ProtonKicker/neptune3pro/Hardware/PCBA/Filament detector/Filament detector bom.xls

Items | Part name | Packag description | Qty | Bit number
1 | SMD Capacitor | 4.7UF/0603/25V/K/X5R，brand restrict ：not | 1 | C1
2 | SMD indicator light led | 0603/blue，brand restrict ：(Everlight Electronics., Ltd.) | 1 | D1
3 | connector | XH2.54-3PW，90 degree connector，Fireproof material | 1 | J1
4 | Transistor | SMD Transistor_SOT-23_SL3400 | 1 | Q1
5 | SMD resistor | 0603_1KR_accuracy 1% | 1 | R5
6 | SMD resistor | 0603_470R_accuracy 1% | 1 | R3
7 | SMD resistor | 0603_2.2KR_accuracy 1% | 1 | R4
8 | SMD resistor | 0603_10KR_accuracy 1% | 2 | R1 R2
9 | optocoupler | BH-ITR20403S brand restrict ：not | 1 | U1
10 | pcb | 18.2×12.6mm，FR-4，two-layer board，FR4_1.6mm，red Soldermask and white silkscreen ， HAL lead free technology ，Through hole and oil，Thickness of copper sheet:1oz，version：EL-A-V3.3.3.102 | 1
