ProtonKicker/neptune3pro/Hardware/PCBA/LED/NEP3_PRO_LED bom.xls

Items | Part name | Packag description | Qty | Bit number
1 | connector | XH2.54MM-2P，SMD Recumbent Soldering，Fireproof material | 1 | 24VIN
2 | SMD resistor | 1206_220R_accuracy 1% | 4 | R1 R2 R3 R4
3 | LED | SMD Recumbent Soldering 3528，white light，20mA，restrict ：not | 24 | U1 U2 U3 U4 U5 U6 U7 U8 U9 U10 U11 U12 U13 U14 U15 U16 U17 U18 U19 U20 U21 U22 U23 U24
4 | PCB | 178*15.2mm，Aluminum substrate，Single layer board，Plate thickness_1.5mm，red Soldermask and white silkscreen ， HAL lead free technology ，Through hole and oil，Thickness of copper sheet:1oz， EL-A-V1.7.72.100 | 1
