ProtonKicker/neptune3pro/Hardware/PCBA/Limit Switch/Y-axis limit switch BOM.xlsx

Limit Switch BOM
Items | Part Name | Specification | UNIT | Qty
1 | PCB | Red | pcs | 1
2 | Switch | Fragment microswitch | pcs | 1
3 | Connector | 2.54-3Pin | pcs | 1
4 | Screws | Cruciform Socket Button Head Tapping screws_Point Tail/PA 2x8 | pcs | 2
