ProtonKicker/neptune3pro/Hardware/3D/Misc Imports/3010 Axial Fan.step

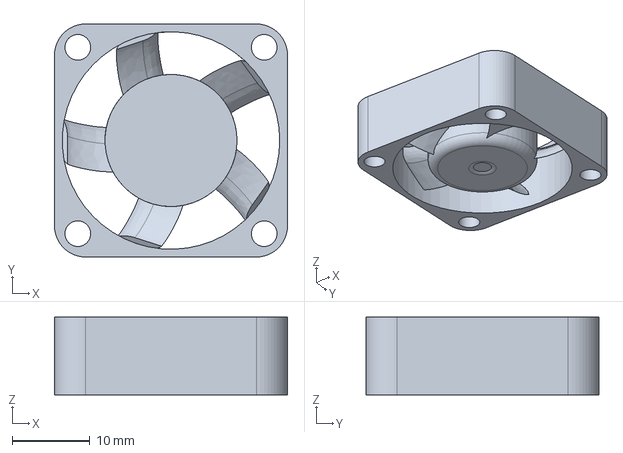
[picture p1: CAD file, 2026-10-06]
Hardware/3D/Misc Imports/3010 Axial Fan.step
30.0 x 30.0 x 10.0 mm
