ProtonKicker/neptune3pro/(list of files, cad)

Other CAD files:
Hardware/Wire/Mainboard Wire.dwg
Hardware/3D/SolidWorks/Power Supply_Kit.SLDASM
Hardware/3D/SolidWorks/Nozzle_Module.SLDASM
Hardware/3D/SolidWorks/Z-axis Driven Plate_Kit.SLDASM
Hardware/3D/SolidWorks/V-slot Wheel kit-1.SLDASM
Hardware/3D/SolidWorks/Extruder_Kit.SLDASM
Hardware/3D/SolidWorks/X-Stepper_Module.SLDASM
Hardware/3D/SolidWorks/Y-Stepper_Kit.SLDASM
Hardware/3D/SolidWorks/V-slot Wheel kit-9.SLDASM
Hardware/3D/SolidWorks/V-slot Wheel kit-8.SLDASM
Hardware/3D/SolidWorks/V-slot Wheel kit-6.SLDASM
Hardware/3D/SolidWorks/Z-Stepper_Kit-Right.SLDASM
Hardware/3D/SolidWorks/V-slot Wheel kit-13.SLDASM
Hardware/3D/SolidWorks/Heated Bed Platform_Module.SLDASM
Hardware/3D/SolidWorks/Filament Detector_Module.SLDASM
Hardware/3D/SolidWorks/Y-axis Timing Belt_Kit.SLDASM
Hardware/3D/SolidWorks/Bottom Aluminum profile_Kit.SLDASM
Hardware/3D/SolidWorks/Bottom Slider Plate_Kit.SLDASM
Hardware/3D/SolidWorks/Extrusion Gear 2 Kit.SLDASM
Hardware/3D/SolidWorks/X-axis Limit switch _Kit.SLDASM
Hardware/3D/SolidWorks/Belt Adjust Bearing Holder_Kit-1.SLDASM
Hardware/3D/SolidWorks/Bottom_Kit.SLDASM
Hardware/3D/SolidWorks/X-axis Timing Belt_Kit.SLDASM
Hardware/3D/SolidWorks/Display screen_Kit.SLDASM
Hardware/3D/SolidWorks/X-axis_Kit.SLDASM
Hardware/3D/SolidWorks/Top Beam_Kit.SLDASM
Hardware/3D/SolidWorks/V-slot Wheel kit-11.SLDASM
Hardware/3D/SolidWorks/V-slot Wheel kit-5.SLDASM
Hardware/3D/SolidWorks/Belt Adjust Bearing Holder_Kit.SLDASM
Hardware/3D/SolidWorks/Bottom Cover Plate_Kit.SLDASM
Hardware/3D/SolidWorks/V-slot Wheel kit-10.SLDASM
Hardware/3D/SolidWorks/Combination Switch_Kit.SLDASM
Hardware/3D/SolidWorks/PEI Platform Sticker_Kit.SLDASM
Hardware/3D/SolidWorks/Y-axis belt Adjust _Kit.SLDASM
Hardware/3D/SolidWorks/Z-Stepper_Kit-Left.SLDASM
Hardware/3D/SolidWorks/Mainboard.SLDPRT
Hardware/3D/SolidWorks/X-axis belt Adjust _Kit.SLDASM
Hardware/3D/SolidWorks/Filament holder_Kit.SLDASM
Hardware/3D/SolidWorks/V-slot Wheel kit-12.SLDASM
Hardware/3D/SolidWorks/V-slot Wheel kit-4.SLDASM
Hardware/3D/SolidWorks/Extruder Shell_Kit.SLDASM
Hardware/3D/SolidWorks/Extruder PCBA.SLDASM
Hardware/3D/SolidWorks/Gearbox_Module(Ä¬ÈÏ-_flexible1).SLDASM
Hardware/3D/SolidWorks/Heated Bed Platform_Kit.SLDASM
Hardware/3D/SolidWorks/Fixing Plate_Extruder_Kit.SLDASM
Hardware/3D/SolidWorks/Bottom Slider Plate_Module.SLDASM
Hardware/3D/SolidWorks/V-slot Wheel kit-7.SLDASM
Hardware/3D/SolidWorks/Bottom Box_Kit.SLDASM
Hardware/3D/SolidWorks/V-slot Wheel kit.SLDASM
Hardware/3D/SolidWorks/V-slot Wheel kit-3.SLDASM
Hardware/3D/SolidWorks/Z-axis Aluminum profile_Kit.SLDASM
Hardware/3D/SolidWorks/V-slot Wheel kit-2.SLDASM
Hardware/2D/2040 Aluminum profile_Right.DWG
Hardware/3D/SolidWorks/624zz V Bearing.SLDPRT
Hardware/Wire/Stepper and limit switch wire_X-axis.dwg
Hardware/2D/Power Supply Cover-Bottom.DWG
Hardware/Wire/Fan Wire.dwg
Hardware/2D/4040 Aluminum profile_Bottom & Right.DWG
Hardware/Wire/Heated Bed Wire.dwg
Hardware/3D/SolidWorks/Level Sensor.SLDPRT
Hardware/Wire/Thermistor_Nozzle.dwg
Hardware/2D/Attraction Plate_Magnet.DWG
Hardware/3D/SolidWorks/4015 Turbo Fan.SLDPRT
Hardware/Wire/Filament Detector and LED Wire.dwg
Hardware/2D/4040 Aluminum profile_Bottom & Left.DWG
Hardware/3D/SolidWorks/Timing Pulley_ID 8.SLDPRT
Hardware/2D/Fixing Plate_Extruder.DWG
Hardware/Wire/stepper and limit switch wire_Y-axis.dwg
Hardware/2D/Cover Plate_Bottom.DWG
Hardware/Wire/Extruder Cable.dwg
Hardware/2D/Extrusion Gear 2.DWG
Hardware/3D/SolidWorks/2GT Timing Belt_Close.SLDPRT
Hardware/Wire/Ground Wire_Power Supply.dwg
Hardware/2D/2040 Aluminum profile_Left.DWG
Hardware/Wire/Filament Detector Wire.dwg
Hardware/2D/2020 Aluminum profile_X-axis.DWG
Hardware/3D/SolidWorks/Axis_Extrusion Gear holder_L27.SLDPRT
Hardware/Wire/Level Sensor.dwg
Hardware/2D/2056 Aluminum profile_Y-axis.DWG
Hardware/3D/SolidWorks/Cable Tie holder.SLDPRT
Hardware/Wire/4010 Turbo Fan.dwg
Hardware/2D/Fixing Plate_Magnet.DWG
Hardware/3D/SolidWorks/Fan holder_Extruder.SLDPRT
Hardware/Wire/Red Silicone Wire(Switch).dwg
Hardware/2D/Fixing Plate_Extruder Fan.DWG
Hardware/3D/SolidWorks/Stepper_X-axis&Y-axis.SLDPRT
Hardware/Wire/4015 Turbo Fan.dwg
Hardware/2D/Power Supply Cover_Left.DWG
Hardware/3D/SolidWorks/Attraction Plate_Magnet.SLDPRT
Hardware/Wire/Red Silicone Wire.dwg
Hardware/2D/Fixing Plate_Y-axis stepper.DWG
Hardware/Wire/Heating Tube.dwg
Hardware/2D/Driven Plate_Z-axis.DWG
Hardware/Wire/6010 Fan.dwg
Hardware/2D/Heat Dissipation Block.DWG
Hardware/3D/SolidWorks/Cover_4040 Aluminum profile.SLDPRT
Hardware/Wire/Black DC Wire.dwg
Hardware/2D/4040 Aluminum profile_Bottom.DWG
Hardware/Wire/Display Screen Wire_Inside.dwg
Hardware/2D/Extrusion Gear 1.DWG
Hardware/3D/SolidWorks/Heated Bed Spacer.SLDPRT
Hardware/Wire/Stepper wire_Z-axis.dwg
Hardware/2D/Fixing Plate_X-axis-stepper.DWG
Hardware/Wire/Red DC Wire.dwg
Hardware/2D/Fixing Plate_Extruder Cable.DWG
Hardware/3D/SolidWorks/Nozzle.SLDPRT
Hardware/Wire/Black Silicone Wire.dwg
Hardware/3D/SolidWorks/Fixing Plate_Magnet(Ä¬ÈÏ).SLDPRT
Hardware/Wire/Thermistor_Heated Bed.dwg
Hardware/2D/Bottom Slider Plate.DWG
Hardware/Wire/LED Wire.dwg
Hardware/2D/Heated Blcok.DWG
Hardware/2D/Power Supply Cover_Right.DWG
Hardware/2D/Fixing Plate_Filament Detector Switch.DWG
Hardware/3D/SolidWorks/PET Plastic Sheet.SLDPRT
Hardware/2D/Fixing Plate_Top Bearing.DWG
Hardware/3D/SolidWorks/Fixing Plate_X-axis-stepper(Ä¬ÈÏ).SLDPRT
Hardware/3D/SolidWorks/Plastic Bottom Cover_Front.SLDPRT
Hardware/3D/SolidWorks/Belt Adjust Bearing Holder.SLDPRT
Hardware/3D/SolidWorks/Filament Detector Shell_Top.SLDPRT
Hardware/3D/SolidWorks/F624ZZ Bearing.SLDPRT
Hardware/3D/SolidWorks/Belt Adjust Shell_Y-axis.SLDPRT
Hardware/3D/SolidWorks/Needle Bearing.SLDPRT
Hardware/3D/SolidWorks/Filament Tube.SLDPRT
Hardware/3D/SolidWorks/Bearing holder_Filament Detector.SLDPRT
Hardware/3D/SolidWorks/Fixing Plate_Top Bearing(Ä¬ÈÏ).SLDPRT
Hardware/3D/SolidWorks/Cover Plate_Bottom(Ä¬ÈÏ).SLDPRT
Hardware/3D/SolidWorks/RJ11 Wire.SLDPRT
Hardware/3D/SolidWorks/2040 Aluminum profile_Left.SLDPRT
Hardware/3D/SolidWorks/Extruder Handle.SLDPRT
Hardware/3D/SolidWorks/Wire Protective Ring.SLDPRT
Hardware/3D/SolidWorks/Silicone Cover_Heating Block.SLDPRT
Hardware/3D/SolidWorks/Fixing Plate_Extruder(Ä¬ÈÏ).SLDPRT
Hardware/3D/SolidWorks/Spring_Extrusion.SLDPRT
Hardware/3D/SolidWorks/Display Screen.SLDPRT
Hardware/3D/SolidWorks/Cable Snap.SLDPRT
Hardware/3D/SolidWorks/X-axis Timing Belt.SLDPRT
Hardware/3D/SolidWorks/Axis_Extrusion Gear_L19.SLDPRT
Hardware/3D/SolidWorks/625zz Bearing.SLDPRT
Hardware/3D/SolidWorks/limit switch holder_Y-axis.SLDPRT
Hardware/3D/SolidWorks/Power Supply Cover-Bottom(Ä¬ÈÏ).SLDPRT
Hardware/3D/SolidWorks/Display screen Shell_Bottom.SLDPRT
Hardware/3D/SolidWorks/Power Supply Cover_Left(Ä¬ÈÏ).SLDPRT
Hardware/3D/SolidWorks/Extruder Stepper Gear.SLDPRT
Hardware/3D/SolidWorks/Belt Adjust Shell_X-axis.SLDPRT
Hardware/3D/SolidWorks/MR93ZZ Bearing.SLDPRT
Hardware/3D/SolidWorks/Copper Sleeve_Timing Belt.SLDPRT
Hardware/3D/SolidWorks/Metal Spacer.SLDPRT
Hardware/3D/SolidWorks/Heat Dissipation Block.SLDPRT
Hardware/2D/Fixing Plate_Z nut-Left.DWG
Hardware/2D/Fixing Plate_Z nut-Right.DWG
Hardware/3D/Inventor/1.75mm Filament_Extruder.ipt
Hardware/3D/Inventor/1.75mm Filament_Filament Detector.ipt
Hardware/3D/Inventor/2.0-20Pin.ipt
Hardware/3D/Inventor/2020 Aluminum profile_X-axis.ipt
Hardware/3D/Inventor/2040 Aluminum profile_Left.ipt
Hardware/3D/Inventor/2040 Aluminum profile_Right.ipt
Hardware/3D/Inventor/2056 Aluminum profile_Y-axis.ipt
Hardware/3D/Inventor/2GT Timing Belt_Close.ipt
Hardware/3D/Inventor/4010 Turbo Fan.ipt
Hardware/3D/Inventor/4015 Turbo Fan.ipt
Hardware/3D/Inventor/4040 Aluminum profile_Bottom & Left.ipt
Hardware/3D/Inventor/4040 Aluminum profile_Bottom & Right.ipt
Hardware/3D/Inventor/4040 Aluminum profile_Bottom.ipt
Hardware/3D/Inventor/6010 Fan.ipt
Hardware/3D/Inventor/624zz V Bearing.ipt
Hardware/3D/Inventor/625zz Bearing.ipt
Hardware/3D/Inventor/625zz Bearing_1.ipt
Hardware/3D/Inventor/625zz Bearing_10.ipt
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
