ProtonKicker/neptune3pro/Hardware/2D/2020 Aluminum profile_X-axis.pdf

4

1 | 2 | 3

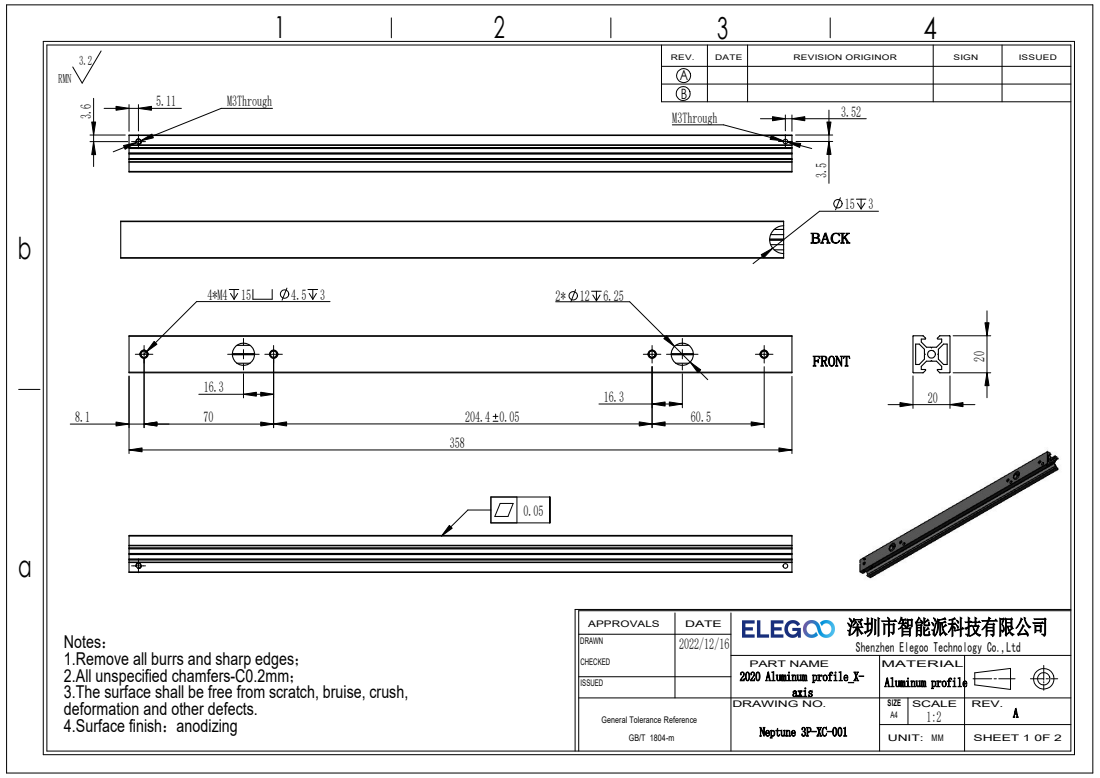
[picture p2: page 1]
Aluminum profile; RMN; M3Through; FRONT; BACK

REV. | DATE | REVISION ORIGINOR | SIGN | ISSUED

APPROVALS | DATE | 深圳市智能派科技有限公司 Shenzhen Elegoo Technology Co.,Ltd
DRAWN CHECKED | 2022/12/16
PART NAME 2020 Aluminum profile_X-axis | MATERIAL
ISSUED
General Tolerance Reference GB/T 1804-m | DRAWING NO. Neptune 3P-XC-001 | SIZE A4 | SCALE 1:2 | REV. A

Notes：
1.Remove all burrs and sharp edges；
2.All unspecified chamfers-C0.2mm；
3.The surface shall be free from scratch, bruise, crush,
deformation and other defects.
4.Surface finish：anodizing

UNIT: MM | | SHEET 1 0F 2
