ProtonKicker/neptune3pro/Hardware/2D/Extrusion Gear 1.pdf

M=0.5

Z=17

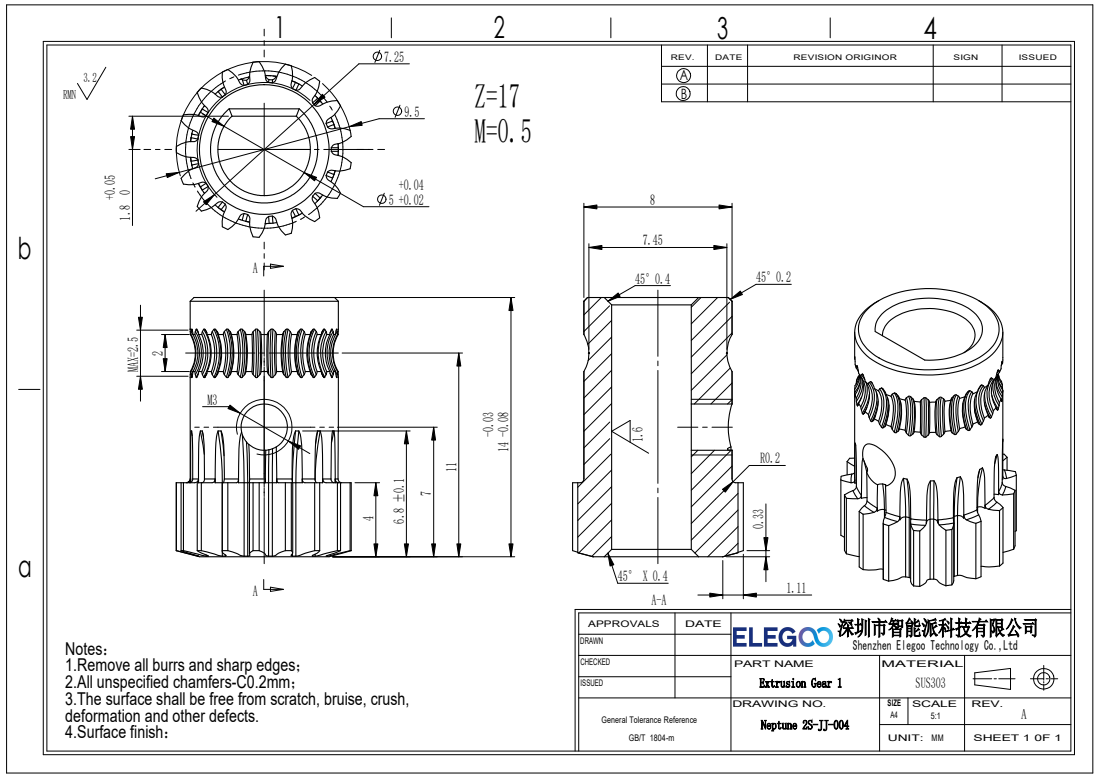
[picture p8: page 1]
MAX=2.5; RMN

REV. | DATE | REVISION ORIGINOR | SIGN | ISSUED

APPROVALS | DATE | 深圳市智能派科技有限公司 Shenzhen Elegoo Technology Co.,Ltd
DRAWN
CHECKED | | PART NAME Extrusion Gear 1 | MATERIAL SUS303
ISSUED
General Tolerance Reference GB/T 1804-m | DRAWING NO. Neptune 2S-JJ-004 | SIZE A4 | SCALE 5:1 | REV. A

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

UNIT: MM | | SHEET 1 0F 1
