ProtonKicker/neptune3pro/Hardware/PCBA/Filament detector/Filament detector_pcb.pdf

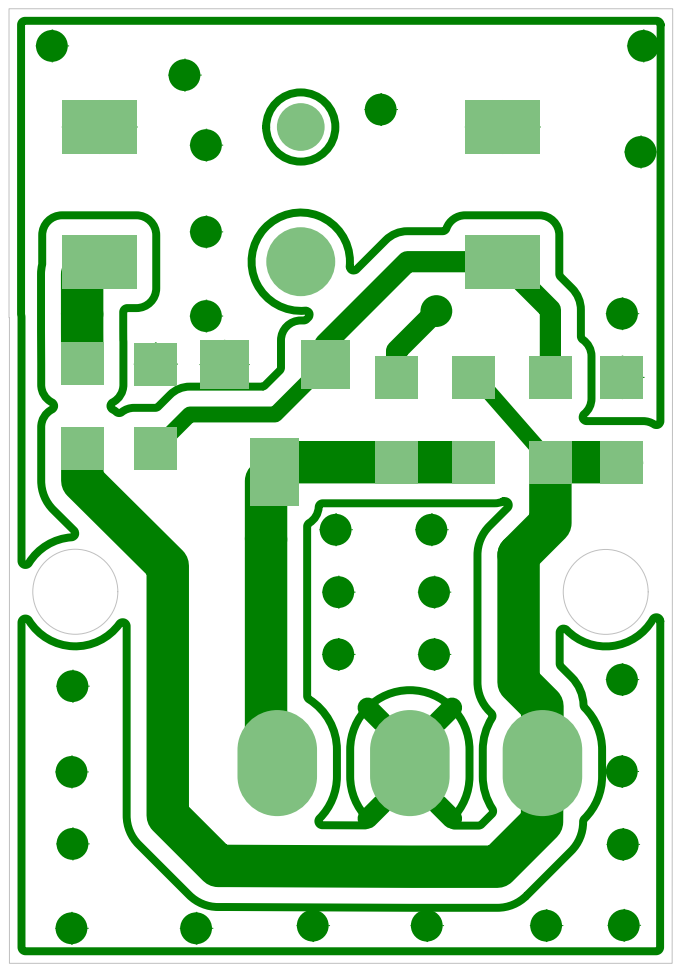
[picture p10: page 1]
U1U¹x1 U¹x2; R1R¹x1 R¹x2; R2R²x1 R²x2; R3R³x1 R³x2; R4R⁴x1 R⁴x2; C1C¹x1; R5R⁵x1 R⁵x2

¼¼ÊõÒªÇó£º
1.È¥Ã«´Ì£¬Àû½Çµ¹¶Û£»
2.Î´×¢µ¹½ÇC0.2£»
3.´ø*ºÅµÄ³ß´çÎªÖØµã³ß´ç£»
4.Î´×¢³ß´ç²ÎÕÕ3DÍ¼£»
5.±íÃæ·ÀÖ¹¹Î»¨¡¢ÅöÉË¡¢Ñ¹ÉË¡¢±äÐÎµÈ²»Á¼¡£
6.±íÃæ´¦Àí£ºÎÞ

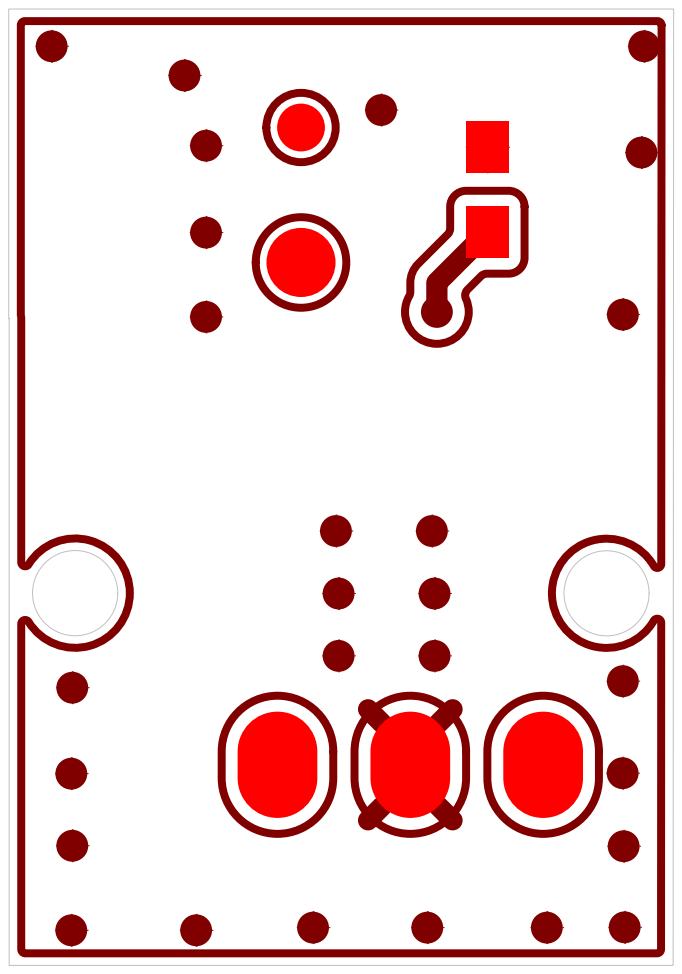
[picture p11: page 2]
U1U¹x5 U¹x6; D1D¹x1 D¹x2

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

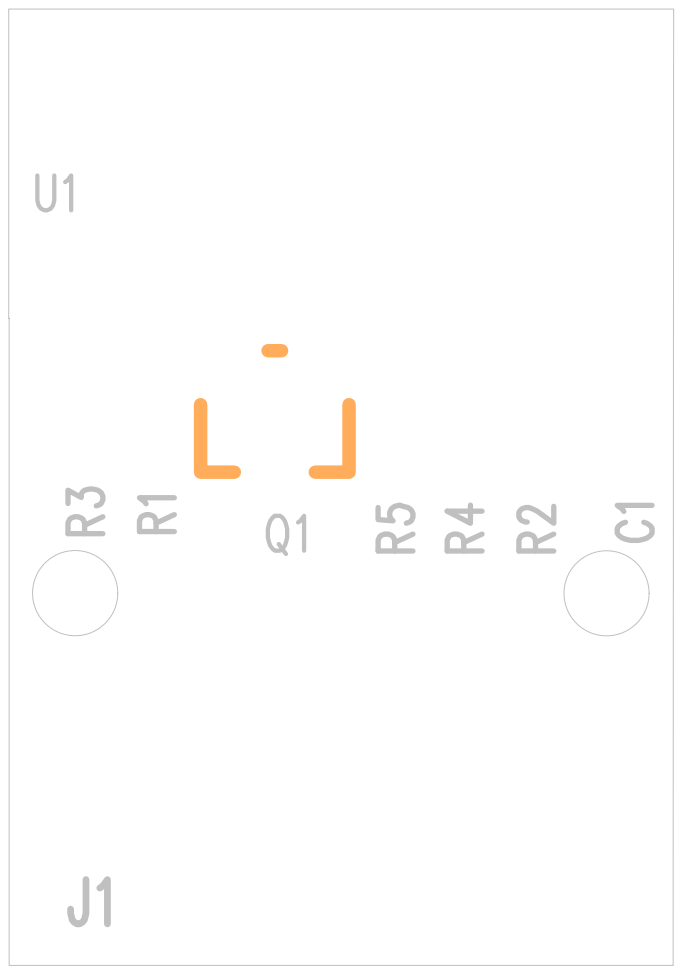
[picture p12: page 3]
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

D1

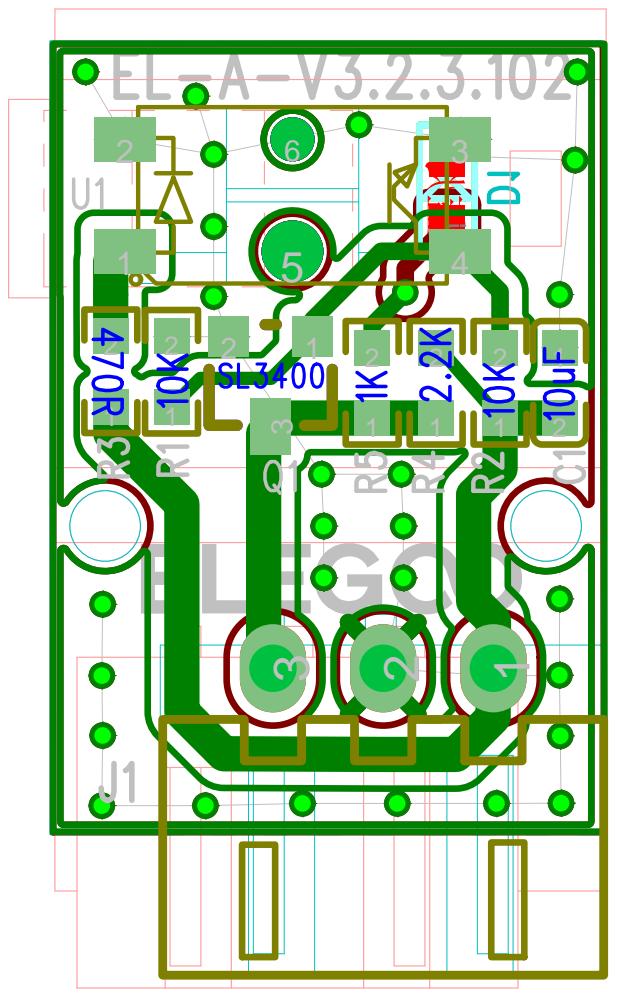
[picture p13: page 5]
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
