ProtonKicker/neptune3pro/(commit log)

2026-09-19 unzip cad
2026-09-19 inventor and solidworks import
    [1.75mm Filament_Extruder.SLDPRT, 1.75mm Filament_Extruder.ipt, 1.75mm Filament_Filament Detector.SLDPRT, 1.75mm Filament_Filament Detector.ipt, 2.0-20Pin.SLDPRT, 2.0-20Pin.ipt, 2020 Aluminum profile_X-axis.SLDPRT, 2020 Aluminum profile_X-axis.ipt]
2026-09-19 add freecad + renamed sw folder
    [1.75mm Filament_Extruder.SLDPRT, 1.75mm Filament_Filament Detector.SLDPRT, 2.0-20Pin.SLDPRT, 2020 Aluminum profile_X-axis.SLDPRT, 2040 Aluminum profile_Left.SLDPRT, 2040 Aluminum profile_Right.SLDPRT, 2056 Aluminum profile_Y-axis.SLDPRT, 2GT Timing Belt_Close.SLDPRT]
2026-10-03 klipper firmware
    [Configuration.h, Configuration_adv.h, firmware.config.txt, firmware.defconfig.txt]
2026-10-03 move files
    [1.75mm Filament_Extruder.SLDPRT, 1.75mm Filament_Extruder.ipt, 1.75mm Filament_Filament Detector.SLDPRT, 1.75mm Filament_Filament Detector.ipt, 2.0-20Pin.SLDPRT, 2.0-20Pin.ipt, 2020 Aluminum profile_X-axis.DWG, 2020 Aluminum profile_X-axis.SLDPRT]
2026-10-03 my config
    [klipper official printer.cfg]
2026-10-06 some ideas but nvm
    [3010 Axial Fan.ipt, 3010 Axial Fan.step, Bridge.0010.ipt, Bridge.ipt, Extrude + Motor.iam, Extruder Stepper Motor.0001.iam, Extruder Stepper Motor.iam, Extruder_Kit.0045.iam]
2026-10-06 random edits in ivt
    [Bottom Box_Kit.0003.iam, Bottom Box_Kit.iam, Bottom_Kit.0001.iam, Bottom_Kit.iam, Extruder + Motor.iam, Extruder_Kit.0045.iam, Extruder_Kit.0058.iam, Extruder_Kit.iam]
